Picatout/lpc810-pong/ressource/photo-prototype.JPG

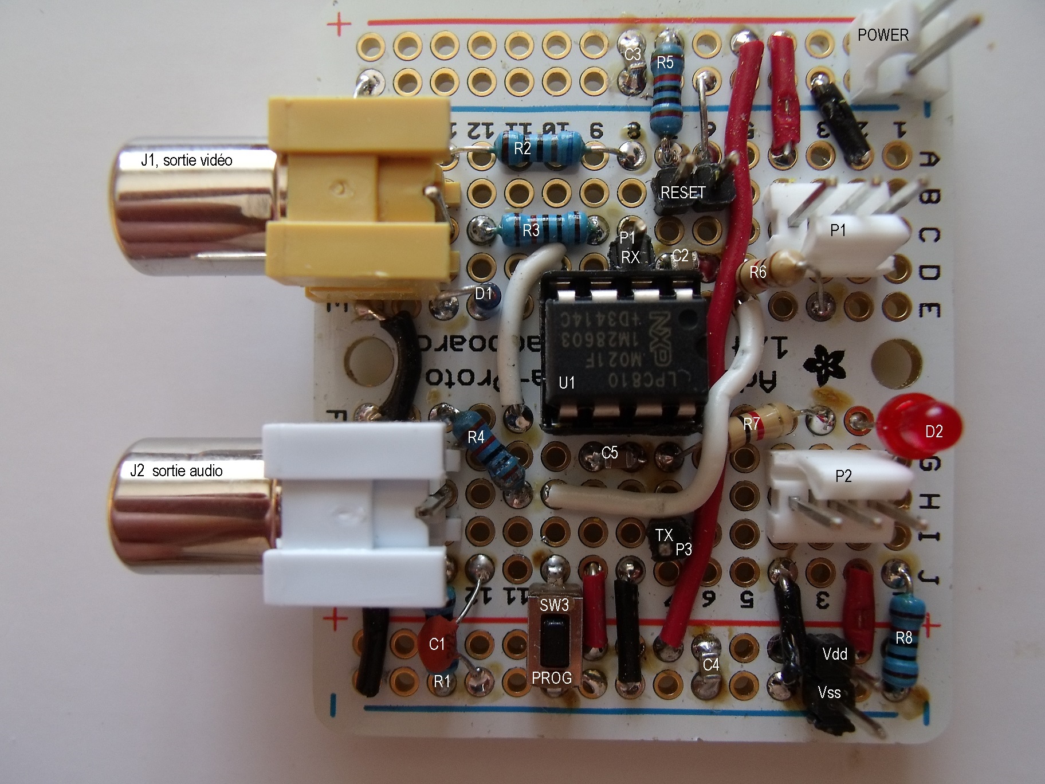
ressource/photo-prototype.JPG
