Picatout/lpc810-pong/README.md

lpc810-pong
===========

jeux pong sur LPC810,  sortie vidéo composite NTSC 

* résolution 64x56
* monochrome
