Picatout/lpc810-pong/ressource/schématique.png

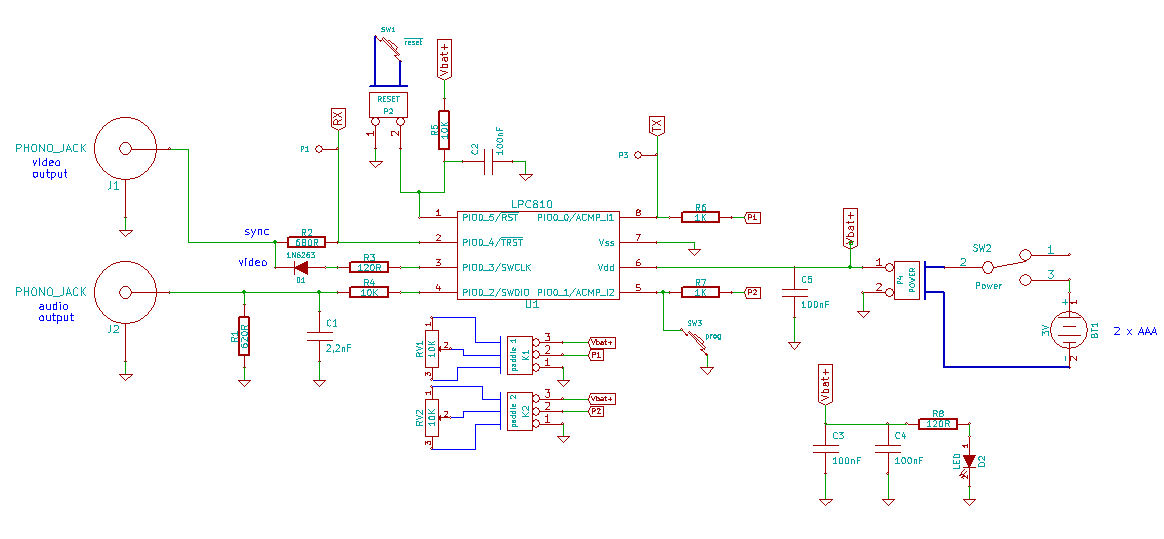
ressource/schématique.png
