Picatout/lpc810-pong/ressource/Schématique.pdf

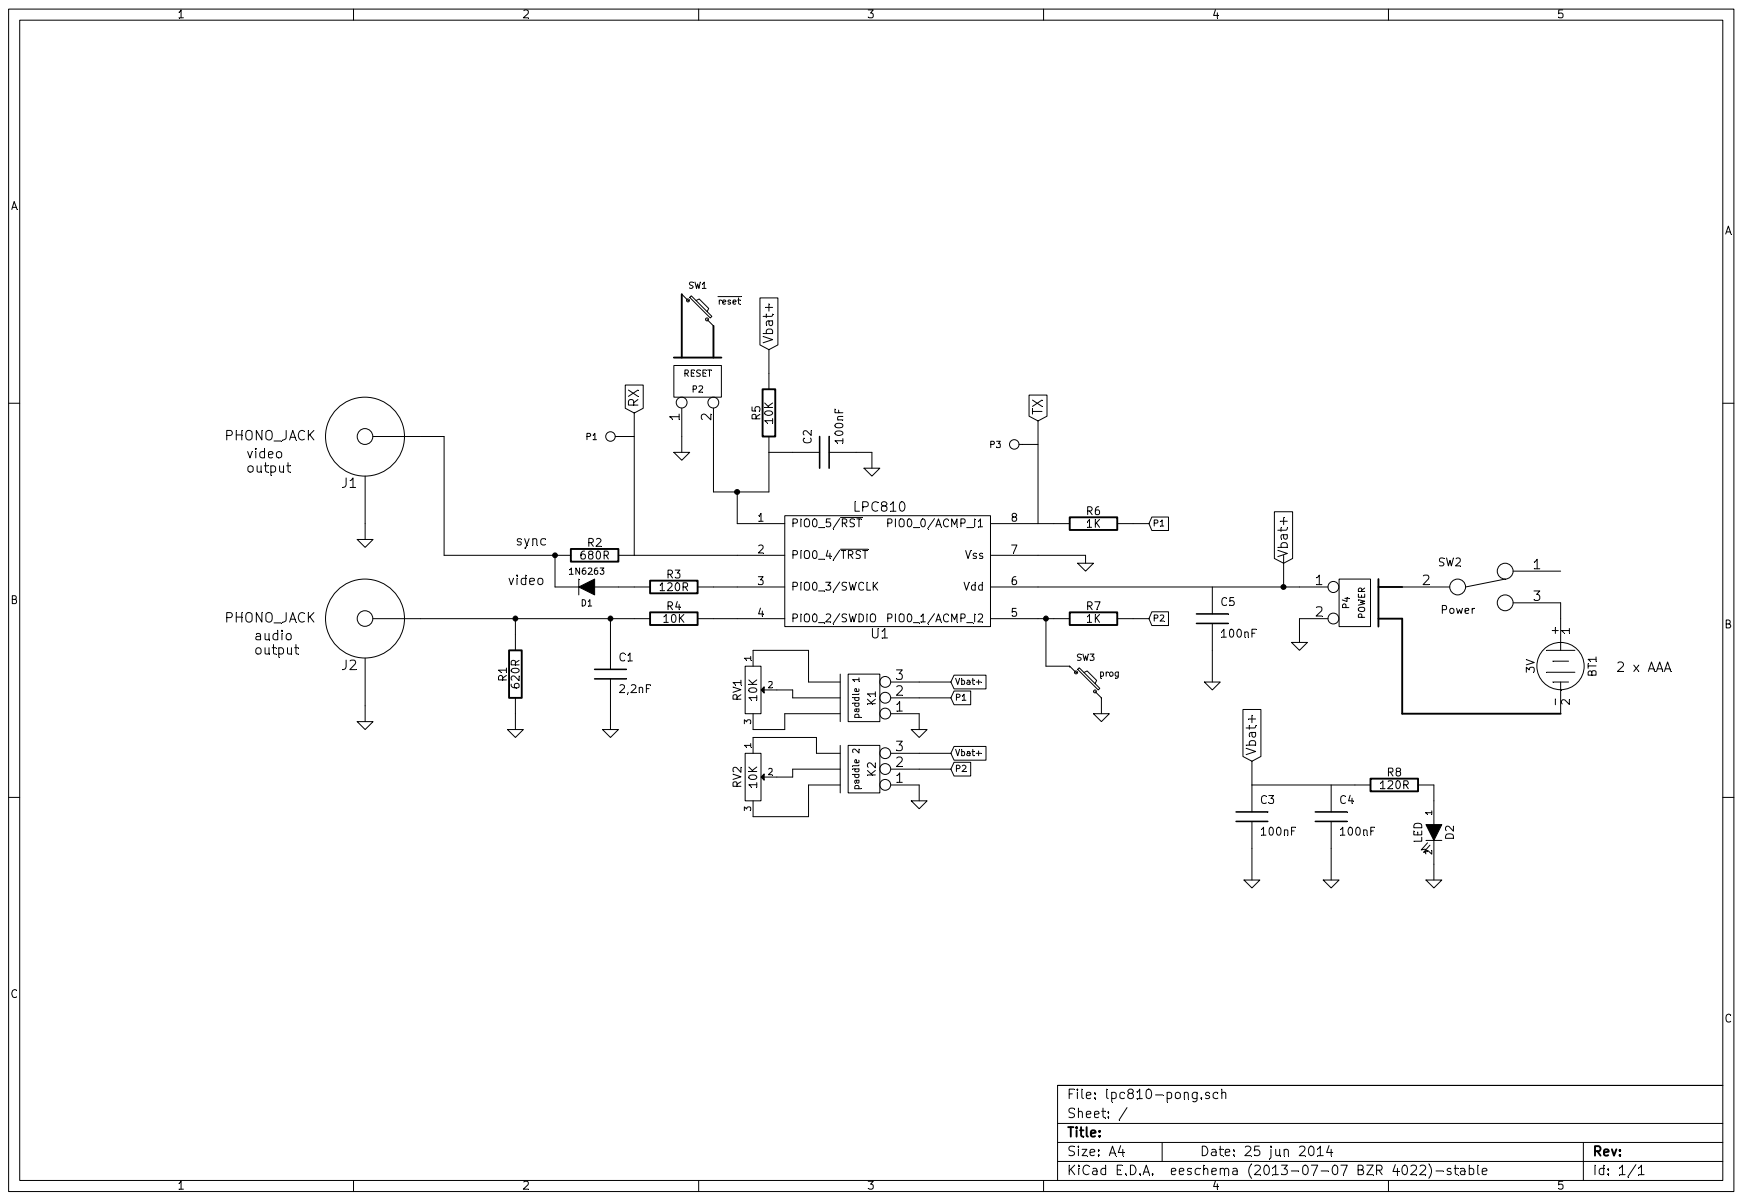
[picture p3: page 1]
