Picatout/lpc810-pong/ressource/lpc810-pong.sch

## KiCad design ressource/lpc810-pong.sch (2014-06-30)

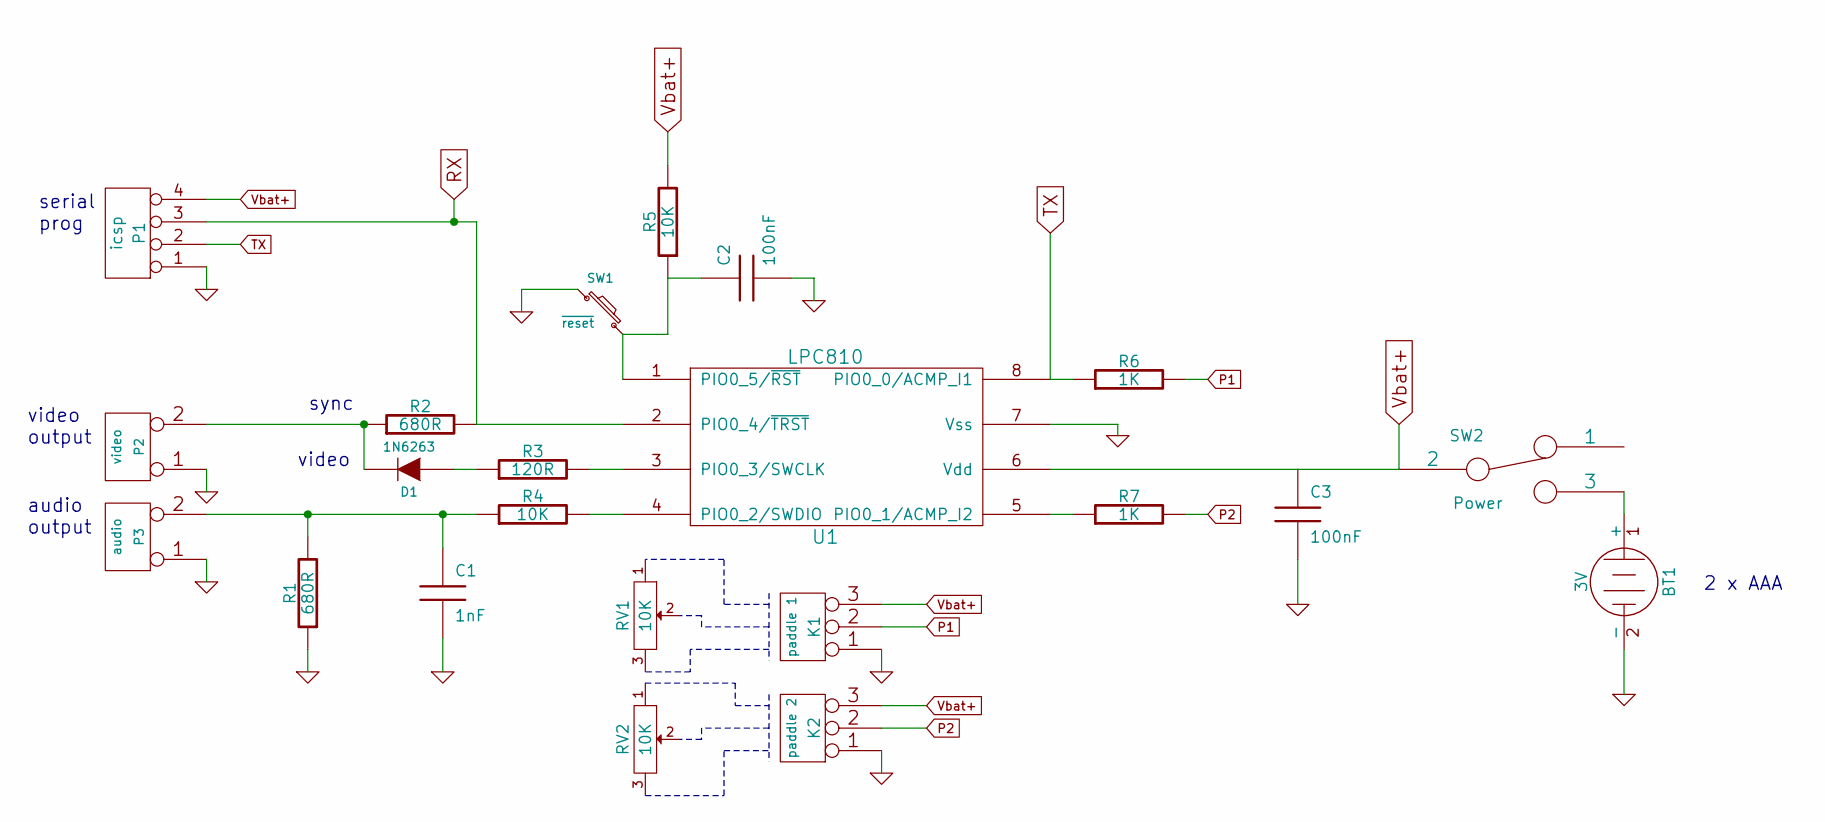
[picture p4: schematic lpc810-pong.sch]

Parts:
BT1: 3V
C1: 1nF
C2, C3: 100nF
D1: 1N6263
K1: paddle 1
K2: paddle 2
P1: icsp
P2: video
P3: audio
R1, R2: 680R
R3: 120R
R4, R5: 10K
R6, R7: 1K
RV1, RV2: 10K
SW1: ~reset
SW2: Power
U1: LPC810

Connections:
GND: BT1.2 (-), C1.2, C2.2, C3.2, K1.1, K2.1, P1.1, P2.1, P3.1, R1.1, SW1.1, U1.7 (Vss)
unnamed: BT1.1 (+), SW2.3
unnamed: C1.1, P3.2 (PM), R1.2, R4.1
unnamed: C2.1, R5.1, SW1.2, U1.1 (PIO0_5/~RST)
unnamed: D1.1 (A), R3.1
unnamed: D1.2 (K), P2.2 (PM), R2.1
unnamed: R3.2, U1.3 (PIO0_3/SWCLK)
unnamed: R4.2, U1.4 (PIO0_2/SWDIO)
unnamed: R7.1, U1.5 (PIO0_1/ACMP_I2)
P1: K1.2 (PM), R6.2
P2: K2.2 (PM), R7.2
RX: P1.3, R2.2, U1.2 (PIO0_4/~TRST)
TX: P1.2, R6.1, U1.8 (PIO0_0/ACMP_I1)
Vbat+: K1.3, K2.3, P1.4, R5.2, SW2.2, U1.6 (Vdd)

Notes on the sheet:
video output
audio output
sync
video
serial prog
2 x AAA
